CharlesGasta/Honda-CBR900RR-SC33-Cluster-Conversion/Tableau_conversion_complet_CBR900RR_SC33_COMPTEUR.pdf

Fiche atelier - correspondance complète des connecteurs | Page 1

# TABLEAU COMPLET DE CONVERSION

### Honda CBR900RR SC33 - compteur 1996-1997 vers faisceau 1998

Connecteurs vus côté broches.

## 1. Tableau complet des correspondances - ordre des broches 20P

Connecteur origine | Broche 20P | Rôle / fonction d'origine | d'origine Couleur | Vers | Connecteur destination | Broche destination | Fonction de destination | Couleur destination
20P | 3 | Masse capteurs | | | | → | 9P | 9 | Masse capteurs
20P | 7 | Signal compte-tours | | | | → | 9P | 2 | Entrée compte-tours
20P | 8 | Signal vitesse | | | | → | 4P | 4 | Entrée vitesse
20P | 9 | Point mort | | | | → | 9P | 3 | Témoin de point mort
20P | 10 | Température moteur | | | | → | 4P | 1 | Entrée température
20P | 11 | +12 V batterie permanent | | | | → | - | - | Pas d'entrée équivalente nécessaire sur le compteur 96-97 | —
20P | 12 | +12 V après contact | | | | → | 4P | 3 | Alimentation compteur
20P | 13 | Masse principale | | | | → | 9P | 1 | Masse compteur
20P | 14 | Clignotant gauche | | | | → | 9P | 7 | Témoin clignotant gauche
20P | 15 | Plein phare | | | | → | 9P | 4 | Témoin de plein phare
20P | 16 | Clignotant droit | | | | → | 9P | 8 | Témoin clignotant droit
20P | 17 | Pression d'huile | | | | → | 9P | 5 | Témoin de pression d'huile
20P | 18 | Béquille latérale | | | | → | 9P | 6 | Témoin de béquille latérale
20P | 19 | Alimentation éclairage | | | | → | 4P | 2 | Éclairage compteur
20P | 20 | Deuxième masse | | | | → | 9P | 1 | Masse complémentaire (raccordement commun possible)

Principe d'origine : le fil Marron du 20P-19 alimente l'éclairage du compteur via le 4P-2 Noir. Le +12 V après contact du 20P-12 alimente uniquement le 4P-3.

Fiche atelier - correspondance complète des connecteurs | Page 2

## 2. Récapitulatif des connecteurs

Connecteur 20P - faisceau 1998

1 | 2 | 3 | 4 | 5 | 6 | 7 | 8 | 9 | 10 | 11 | 12
13 | 14 | 15 | 16 | 17 | 18 | 19 | 20

Disposition correcte : 1 à 12 en haut ; 13 à 16 en bas à gauche ; 17 à 20 en bas à droite.

Connecteur 9P - compteur 1996-1997

Verrou

1 | 2 | 3
4 | 5 | 6
7 | 8 | 9

1 Masse - 2 Compte-tours - 3 Point mort - 4 Plein phare - 5 Huile - 6 Béquille - 7 Clignotant G - 8 Clignotant D - 9 Masse capteurs.

Connecteur 4P - compteur 1996-1997

Verrou

1 | 2 | 3

4

1 Température - 2 Éclairage - 3 +12 V après contact - 4 Vitesse.

## 3. Information importante

Dans les correspondances de couleurs, la première couleur indiquée correspond à la couleur principale du câble.

La seconde couleur correspond au liseré (rayure) du câble.
