CharlesGasta/Honda-CBR900RR-SC33-Cluster-Conversion/(commit log)

2026-07-30 Enhance README with cluster conversion details
    Added detailed documentation for adapting the Honda CBR900RR SC33 instrument cluster from 1996-1997 to a 1998 wiring harness, including pinout conversion, wire colors, and validation information.
2026-08-09 M.A.J. code
    🇫🇷 Français — V20.2
    Correctifs et nouveautés
    Ajout du tarage automatique du compte-tours.
    Nouveau bouton permettant d'indiquer à l'ESP que le moteur tourne à 1100 tr/min au ralenti stable.
    Calcul automatique d'un facteur de correction à partir du régime réellement mesuré.
    Sauvegarde du facteur de calibration en mémoire.
    Affichage dans le diagnostic du RPM brut, du RPM corrigé et du facteur de calibration.
    Ajout du tarage de la température moteur à froid.
    Possibilité d'indiquer la température ambiante réelle.
    Enregistrement de la résistance de la sonde lorsque le moteur est complètement froid.
    Utilisation de ce point comme nouvelle référence ba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
2026-08-13 M.A.J. code
    🇫🇷 Français
    V20.2.1 — Calibration et correctifs
    Cette version ajoute plusieurs fonctions de calibration directement depuis l'interface Wi-Fi du NodeMCU afin de faciliter le réglage du système une fois installé sur la moto.
    Nouveautés
    Calibration automatique du compte-tours
    Ajout d'un bouton de tarage à 1100 tr/min.
    Lorsque le moteur est stabilisé au ralenti à 1100 tr/min, une simple pression sur le bouton permet au NodeMCU de calculer automatiquement le facteur de correction nécessaire.
    Le facteur de calibration est sauvegardé en mémoire et appliqué aux mesures suivantes.
    Le diagnostic affiche désormais :
    RPM brut
    RPM corrigé
    facteur de calibr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
2026-08-14 M.A.J. code
    V20.3.1 — Shift moteur froid/chaud + correction compte-tours
    🆕 Nouveautés
    Ajout d'un mode Shift-Light moteur froid / moteur chaud
    Le régime de Shift-Light peut maintenant être différent selon la température moteur.
    Lorsque le moteur est sous la température définie, un seuil de régime réduit est utilisé.
    Une fois la température minimale atteinte, le système passe automatiquement aux seuils normaux du moteur chaud.
    Nouveau seuil de Shift-Light à froid
    Valeur par défaut : 8000 tr/min.
    Lorsque le moteur est froid, le Shift-Light clignote à partir de ce régime.
    Le seuil est entièrement réglable depuis l'interface Wi-Fi.
    Nouveau seui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
